fasaiph/AirPatrol/README.md

# AirPatrol
An add-on to a drone so you can measure air quality remotely!
