fasaiph/AirPatrol/PCB/finalpcb_tz12_fp10.brd

## EAGLE design PCB/finalpcb_tz12_fp10.brd (2018-09-13)

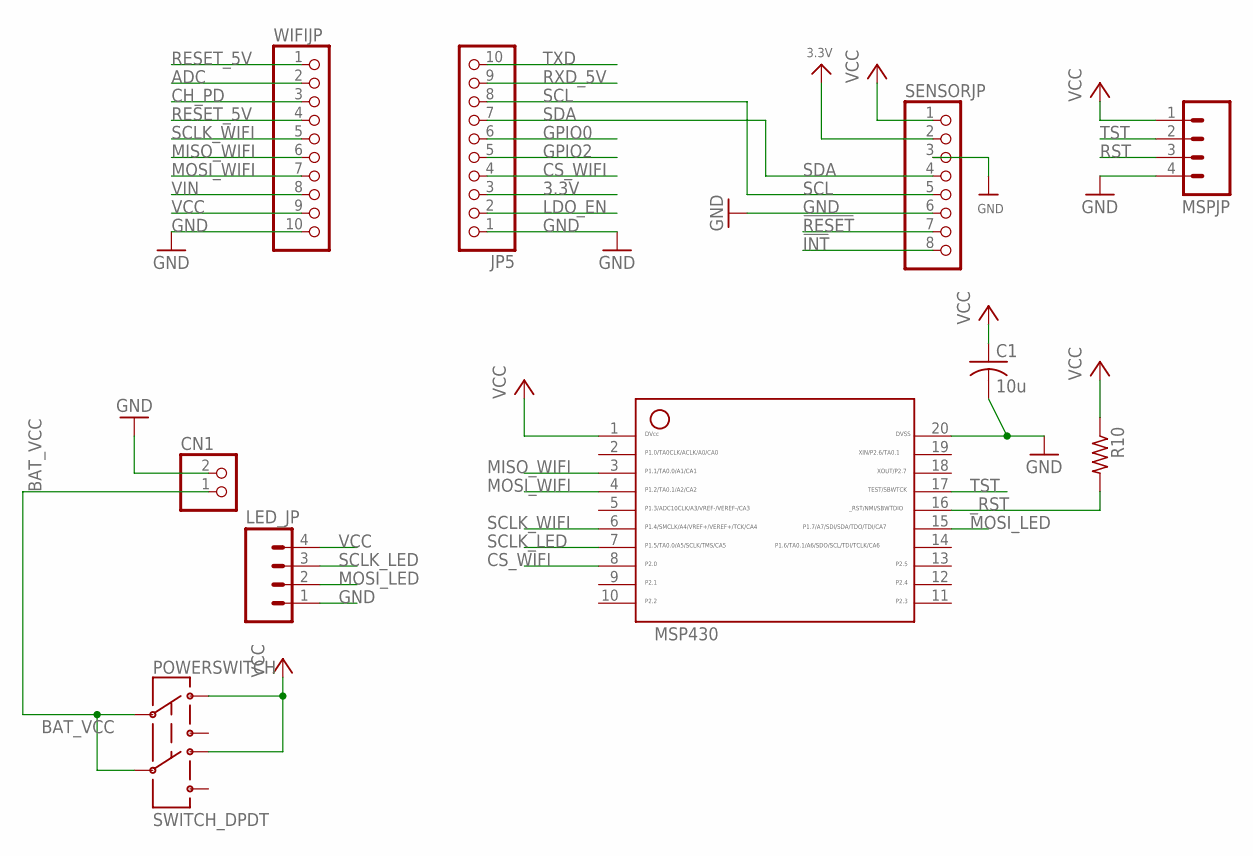
[picture p5: schematic finalpcb_tz12_fp10.sch]

Parts:
C1: 10u; C1206
CN1: JST_2PIN-SMT-RA; JST-PH-2-SMT-RA
JP5: HEADER-1X1070MIL; 1X10_ROUND70
LED_JP: PENDANT_M04LOCK; PENDANT_1X04_LOCK
MSP430: RATDBS_MSP430; RATDBS_20_PIN
MSPJP: PENDANT_M04LOCK; PENDANT_1X04_LOCK
POWERSWITCH: SWITCH_DPDT; JS_DPDT_TH
R10: R-US_R1206; R1206
SENSORJP: HEADER-1X870MIL; 1X08_ROUND_70
WIFIJP: HEADER-1X1070MIL; 1X10_ROUND70

Connections:
3.3V: JP5.3, SENSORJP.2
!INT: SENSORJP.8
!RESET: SENSORJP.7
ADC: WIFIJP.2
BAT_VCC: CN1.1 (2), POWERSWITCH.2, POWERSWITCH.5
CH_PD: WIFIJP.3
CS_WIFI: JP5.4, MSP430.8
GND: C1.2, CN1.2 (1), JP5.1, LED_JP.1, MSP430.20, MSPJP.4, SENSORJP.3, SENSORJP.6, WIFIJP.10
GPIO0: JP5.6
GPIO2: JP5.5
LDO_EN: JP5.2
MISO_WIFI: MSP430.3, WIFIJP.6
MOSI_LED: LED_JP.2, MSP430.15
MOSI_WIFI: MSP430.4, WIFIJP.7
RESET_5V: WIFIJP.1, WIFIJP.4
RST: MSPJP.3
RXD_5V: JP5.9
SCL: JP5.8, SENSORJP.5
SCLK_LED: LED_JP.3, MSP430.7
SCLK_WIFI: MSP430.6, WIFIJP.5
SDA: JP5.7, SENSORJP.4
TST: MSP430.17, MSPJP.2
TXD: JP5.10
VCC: C1.1, LED_JP.4, MSP430.1, MSPJP.1, POWERSWITCH.1, POWERSWITCH.4, R10.1, SENSORJP.1, WIFIJP.9
VIN: WIFIJP.8
_RST: MSP430.16, R10.2

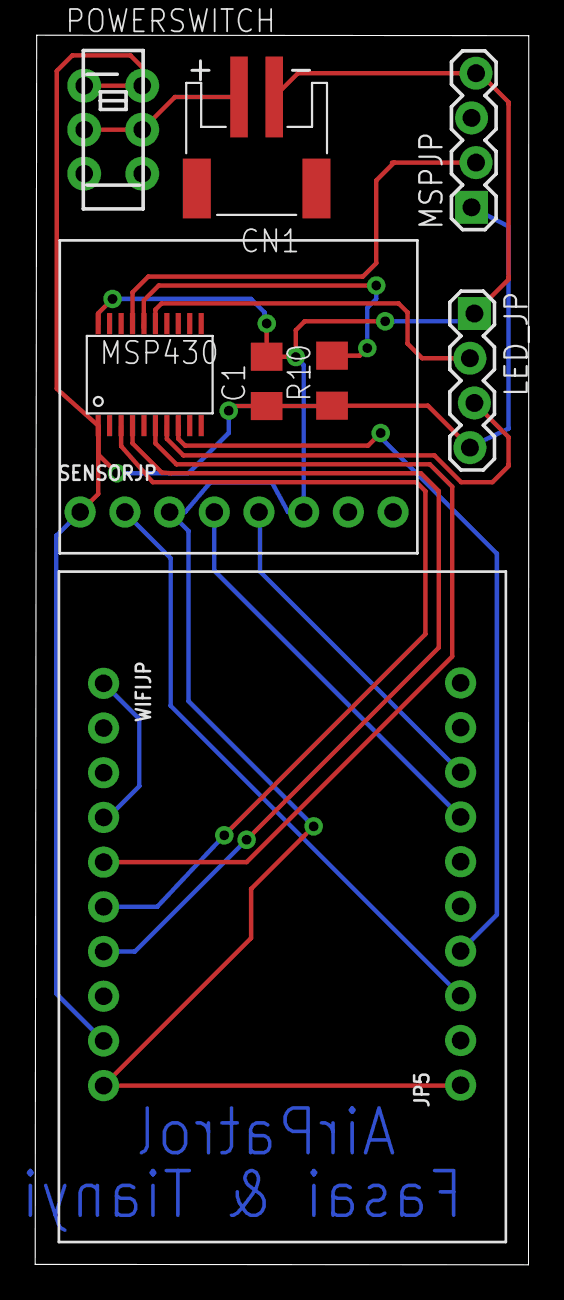
[picture p6: board finalpcb_tz12_fp10.brd from above]

Board: 2 copper layers, 28.0 x 69.9 mm, 10 parts (0 on the bottom side), 15 nets.
